pollockDeVis/hardware_sparrow_migrated/README.md

##  Hardware Features for Sparrow v1.0.0

1. Design similar to ESP WROOM32 DevkitC board (including the power supply using voltage regulator) except for the UART-USB bridge.

2.  Size of the board is roughly 60 mm by 30 mm

3. Tag-Connect TC2030 for programming or (ref: http://www.designhmi.com/wp-content/uploads/2015/03/153.jpg

4. Pinouts for UART debug messages

5. Port for DC power input: micro USB port 5V intake

6. Two [6 pin connectors](https://www.alibaba.com/product-detail/2-54mm-Pitch-Molex-6-Pin_60759974767.html) (2.54 mm pitch) on both sides

7. One push buttons (1 push button from the ESP32 DevkitC Design for Reset).

8. One SMD RGB LED as an indicator connected to GPIO.

9. One conductive pad connected to GPIO4 (Capacitive touch pin)

10. Pinouts from the microcontroller for future debugging.   

**Design Notes:** ESP WROOM 32 Boot Mode Selection Guidelines: https://github.com/espressif/esptool/wiki/ESP32-Boot-Mode-SelectionEsp32_hardware_design_guidelines_en document in the folderEsp32-wroom-32_datasheet_en in the folder. 

**Additonal Note:**Kuarq PCB Design -Main Design Folder contains the old PCB designed for this application.ESP32 Sample PCB design KiCad contains a sample KiCad ESP32 PCB design for referenceESP32-DevKitC-V4_Reference_Design contains the design and schematics for ESP32-DevKitC V4 on which the PCB is based upon.            

**1.**	**Main Schematic** 4th Pin-Connected to GPIO16 (RX) in the input and GPIO17(TX) is connected to the 4th pin on the output. 

																			**Fig-1: Input 1 and Output1**  

**2. ESP WROOM-32 Schematic** 

**3. Power Supply**

  

**4. Reset Button Connected to EN pin**

  

**5. Exposed Programming Pins** GPIO 0, GPIO 1 (TX), GPIO 3 (RX), EN, GND, VCC 

**6. Conductive Pad connected to Capacitive sensing GPIO** Small square conductive pad connected to GPIO 4.

  **7. SMD RGB LED Pins** GPIO 16, GPIO 17, GPIO 18 should be used for R, G, and B respectively.  

**8. Exposed pins (holes) for future debugging and Addition** *ADC:*GPIO 36, GPIO 39, GPIO 32, GPIO 33*DAC:*GPIO 25, GPIO 26*I2C:*GPIO 21. GPIO 22*Others:*GPIO13, GPIO19, GPIO23, GPIO 27                              

**9. Dimensions of ESP32**  

**10. Dimensions of Raspberry pi zero w**                             **11. Secondary Six pin connectors for Input Output 2**     

**12. Outline and dimension of new PCB according to Raspberry pi zero** **Pictures****** ******** ****
