pollockDeVis/hardware_sparrow_migrated/hunscan_V100_DCI_BOM.xlsx

HUNSCAN BOMList(V1.0.0 DCI)
Item | Ref Des | Qty | Manufacturer | Mfg Part# | Value | Description | Package |  | ICs | Link
1 | C1, C4, C8, C9, C10 | 5 |  |  | 10 uF | Ceramic Capacitor | 0402 | SMD | Capacitor
2 | C2, C3, C5, C6, C7 | 5 |  |  | 0.1 uF/50V (10%) | Ceramic Capacitor | 0402 | SMD | Capacitor
3 | R1 | 1 |  |  | 10K Ohm (5%) | Chip Resistors | 0402 | SMD | Resistor
4 | R2 | 1 |  |  | 330 Ohm (5%) | Chip Resistors | 0402 | SMD | Resistor
5 | R3 | 1 |  |  | 10K Ohm (5%) | Chip Resistors | 0402 | SMD | Resistor
6 | U2, U3 | 2 | AMS | AMS1117-3.3 | AMS1117-3.3 | LDO, 5V 转 3.3V 固定输出, 1A, SOT-223 (LDO, 5V/3.3V, 1A, SOT-223) | SOT-223 | SMD | Power ICs
7 | D1 | 1 | Wurth Elektronik |  | BLUE LED | light-emitting diode: BLUE | 0402 | SMD | Diode
8 | SW1 | 1 | Omron Electronics | B3U-1000P | B3U-1000P | Tactile Switches Top Actuated w/o boss w/o ground | Tact Switch | SMD | Tact Switch | https://tinyurl.com/ukhpnt6
9 | U1 | 1 | **Espressif | ESP32-WROOM-32D (4MB) | ESP32-WROOM-32D (4MB) | ESP32-D0WD, 32Mbits SPI flash | ESP32_MODULE | SMD | Module | https://my.mouser.com/ProductDetail/Espressif-Systems/ESP32-WROOM-32D-4MB
10 | PWR3 | 1 |  |  | USB_Micro-B_Molex-105017-0001 | USB - micro B USB 2.0 Receptacle Connector 5 Position Surface Mount, Right Angle; Through Hole |  |  | Connector | https://www.digikey.my/product-detail/en/molex/1050170001/WM1399CT-ND/2350885?productid=
11 | D2 | 1 |  | TSS0340U RGG | 150mW | Schottky Diodes & Rectifiers Schottky 150mW | 0603 | SMD | Diode | https://my.mouser.com/ProductDetail/Taiwan-Semiconductor/TSS0340U-RGG?qs=QEzMiVqgwc0IWpzjx4IhRg==
12 | L1 | 1 |  | LQM18PH1R0MFRL | 1uH 20% 360mA 0.25ohm | Fixed Inductors 0603 1uH 20% 360mA 0.25ohm | 0603 | SMD | Inductor | https://my.mouser.com/ProductDetail/Murata-Electronics/LQM18PH1R0MFRL?qs=rkhjVJ6%2F3EIdfbYqdWbcig%3D%3D
 | **Espressif chip must be sourced directly from the manufacturer
