pollockDeVis/hardware_sparrow_migrated/(commit log)

2019-03-04 Quark v1.0.0 PCB design
    [pcbtest-nrf24_breakout-B.Cu.gbl, pcbtest-nrf24_breakout-B.Mask.gbs, pcbtest-nrf24_breakout-B.Paste.gbp, pcbtest-nrf24_breakout-B.SilkS.gbo, pcbtest-nrf24_breakout-Edge.Cuts.gm1, pcbtest-nrf24_breakout-F.Cu.gtl, pcbtest-nrf24_breakout-F.Mask.gts, pcbtest-nrf24_breakout-F.Paste.gtp]
2019-11-20 Added Sparrow PCB v1.0.0 design to the master branch
    [esp-break.kicad_pcb, esp-break.sch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]
2019-11-21 Updated the lables for First and Second version of the Board (Coin and Washing) and Readme. Next Step: Logo and Labels placement
    [esp-break.kicad_pcb, esp-break.sch]
2019-11-21 Filled up the front copper layer with ground copper fills and removes soldermask from the touch pad
2019-11-21 Updated and repositioned the labels
    [esp-break.kicad_pcb]
2019-11-21 Added BOM and DF logo and Sparrow Logo
    [esp-break.kicad_pcb, sparrow_v1_BOM_global.xlsx]
2019-11-21 Added logo, front copper fills, rerouting and model number. Updated BOM file
    [esp-break.kicad_pcb, sparrow_v1_BOM_global.xlsx]
2019-11-21 Straightened the bottom edge of the board; Bottom copper fill connected to the ground and minor retracing
    [esp-break.kicad_pcb]
2019-11-21 Updated BOM file with PWR2 and gerber files
    [esp-break.kicad_pcb, sparrow_v1_BOM_global.xlsx]
2019-11-23 Updated micro usb footprint and tracing
    [esp-break.kicad_pcb]
2019-11-23 updated BOM files for coin
    [Sparrow Coin_UPDATED.xlsx]
2019-12-11 Updated the PCB with 5V - 3.3 bidirectional level converter. Changed rx tx pin to rx2 and tx2 to the output and input. Added rx line to 5th pin of coin machine to understand successful coin drop and 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
    [esp-break.kicad_pcb]
2019-12-12 Aligned the kf2510 connector holes and the resistors to avoid clash. Had to change the footprint of some resistors to give more space
    [esp-break.kicad_pcb]
2019-12-12 changed the footprint of all smd components from 1206 to 0603
    [esp-break.kicad_pcb]
2019-12-12 Changed the positions and orientation of resistors and mosfets
    [esp-break.kicad_pcb]
2019-12-12 Changed the orientation of the label of a resistor
    [esp-break.kicad_pcb]
2019-12-13 Minor trace modification and checked by Ovee. Updated the footprints in the schematics as well
    [esp-break.kicad_pcb, esp-break.sch]
2019-12-13 Reoriented the jst power connector, refilled some regions and verified the measurement of the jst connector position with the previous design
    [esp-break.kicad_pcb]
2019-12-13 Added final gerber, BOM, pickNplace and drill files with minor changes on the PCB front silkscreen layer
    [Sparrow Coin_UPDATED.xlsx, Sparrow_V101LF_COIN_BOM.xlsx, Sparrow_V101LF_WASH_DRY_BOM.xlsx, esp-break.kicad_pcb, sparrow_v1_BOM_global.xlsx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]
2019-12-13 changed the label of PWR1
    [esp-break-B_Cu.gbl, esp-break-B_Mask.gbs, esp-break-B_Paste.gbp, esp-break-B_SilkS.gbo, esp-break-Edge_Cuts.gm1, esp-break-F_Cu.gtl, esp-break-F_Mask.gts, esp-break-F_Paste.gtp]
2019-12-13 Updated gerber, drill and pos file
    [esp-break-B_CrtYd.gbr, esp-break-B_Cu.gbl, esp-break-B_Fab.gbr, esp-break-B_Mask.gbs, esp-break-B_SilkS.gbo, esp-break-Edge_Cuts.gm1, esp-break-F_CrtYd.gbr, esp-break-F_Cu.gtl]
2019-12-14 Updated the footprint of microusb port
    [esp-break.kicad_pcb]
2019-12-14 Updated the gerber, picknplace and BOM files and fixed some mistakes
    [Sparrow_V101LF_BOM.xlsx, Sparrow_V101LF_COIN_BOM.xlsx, Sparrow_V101LF_WASH_DRY_BOM.xlsx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]
2020-06-20 hunscan final layout. Need to configure the tracing
    [Sparrow_V101LF_BOM.xlsx, Sparrow_V101LF_COIN_BOM.xlsx, Sparrow_V101LF_WASH_DRY_BOM.xlsx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]
2020-06-20 Added logos and labels and revised the design
    [esp-break.kicad_pcb]
2020-06-20 Updated diode and inductor position. Put in version number
    [esp-break.kicad_pcb]
2020-06-20 Additional Tracing done. Need to rearrange the vias and take care of the logos
    [esp-break.kicad_pcb]
2020-06-21 Updated the logos with F.Cu Layer
    [esp-break.kicad_pcb]
2020-06-21 Updated vias and routing
    [esp-break.kicad_pcb]
2020-06-21 Generated BOM & Gerber
    [esp-break-B_CrtYd.gbr, esp-break-B_Cu.gbl, esp-break-B_Fab.gbr, esp-break-B_Mask.gbs, esp-break-B_Paste.gbp, esp-break-B_SilkS.gbo, esp-break-Edge_Cuts.gm1, esp-break-F_CrtYd.gbr]
2020-06-21 Updated BOM file
    [hunscan_V100_DCI_BOM.xlsx]
2020-06-29 Updated BOMfile with links
    [hunscan_V100_DCI_BOM.xlsx]
2020-06-29 Updated PCB layout with new Temp Sensor Footprint
    [esp-break.kicad_pcb]
2020-06-29 Updated with Proximity sensor footprint connector
    [esp-break.kicad_pcb, esp-break.sch]
2020-06-29 Updated BOM and Gerber
    [esp-break-B_CrtYd.gbr, esp-break-B_Cu.gbl, esp-break-B_Fab.gbr, esp-break-B_Mask.gbs, esp-break-B_Paste.gbp, esp-break-B_SilkS.gbo, esp-break-Edge_Cuts.gm1, esp-break-F_CrtYd.gbr]
2020-07-01 Updated Gerber
    [esp-break-B_CrtYd.gbr, esp-break-B_Cu.gbl, esp-break-B_Fab.gbr, esp-break-B_Mask.gbs, esp-break-B_Paste.gbp, esp-break-B_SilkS.gbo, esp-break-Edge_Cuts.gm1, esp-break-F_CrtYd.gbr]
2020-07-01 Updates on the pcb
    [esp-break.kicad_pcb]
